OS-MPPT/os-mppt.github.io/index.md

# OS-MPPT: The OS-Some MPPT

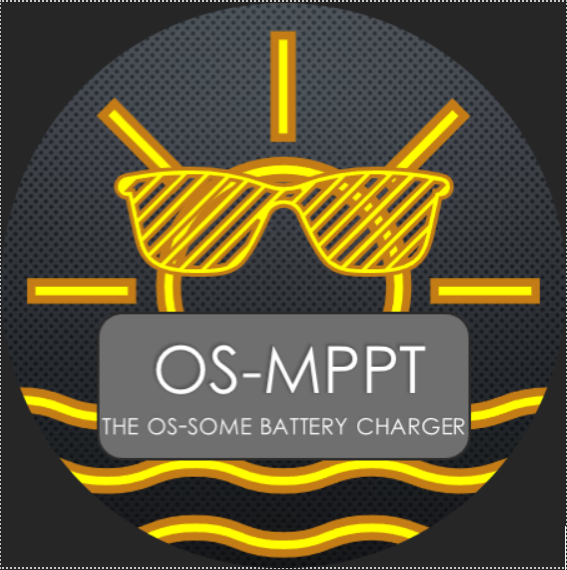
[picture p1: assets/SunnyOSMPPT.png]
Sunny


## OS? MPPT? What's that?
We are the OS-MPPT project! This is an Open-Source Maximum Power Point tracker project as researched and designed by our Senior Design team at K-State. 

## Okay, but what's an MPPT?
A Maximum Power Point Tracker uses readings coming off your solar panels and adjusts its power conversion step in order to maximize the power going to the attached load.

It sounds quite complicated, doesn't well? Well, that leads us right into...

## What's this project about?
We wanted to better understand MPPT operations and be able to then share that knowledge to other ambitious engineers, DIYers, and researchers alike. So, what'd we do? We assembled a senior design team in order to research, design, and construct a MPPT system, hopefully in a way that leaves lots of loose ends for future designers to iterate on. 

## Alrighty, where do I start?
We've set up a small network of information systems in order to manage and organize both our designs and technical notes. 

You can find both our digital and our electrical design files here:
[OS-MPPT Electrical Design](https://github.com/tjtiede/OSMPPT)

And last but certainly not least, you can find additional design and technical notes at this blog page!
