OS-MPPT/os-mppt.github.io/assets/os-mppt_MainBoard_Top.stl

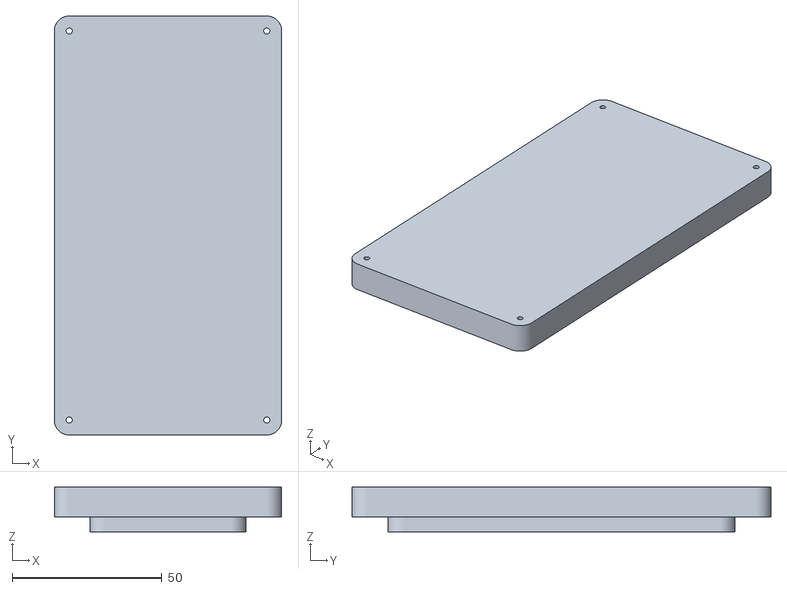
[picture p9: CAD file, 2026-05-04]
assets/os-mppt_MainBoard_Top.stl
76.0 x 140.0 x 15.0
