OS-MPPT/os-mppt.github.io/assets/os-mppt_MainBoard_Bottom.stl

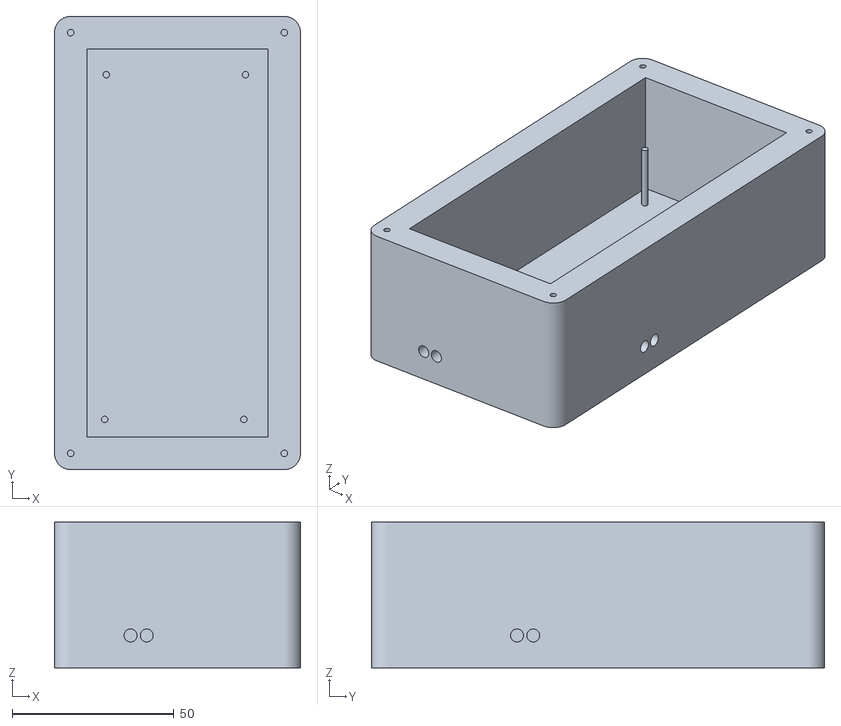
[picture p10: CAD file, 2026-05-04]
assets/os-mppt_MainBoard_Bottom.stl
76.0 x 140.0 x 45.0
