OS-MPPT/os-mppt.github.io/assets/os-mppt_ExternalSense_box.stl

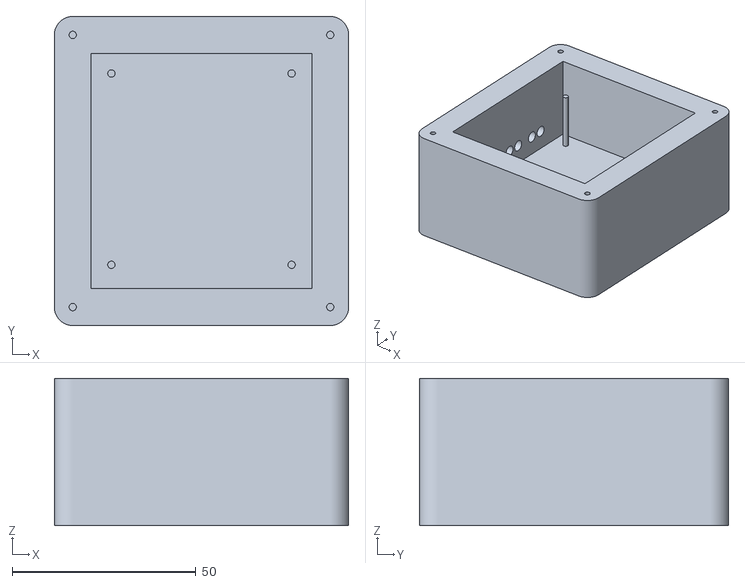
[picture p11: CAD file, 2026-05-04]
assets/os-mppt_ExternalSense_box.stl
80.0 x 84.0 x 40.0
