OS-MPPT/os-mppt.github.io/assets/os-mppt_ExternalSense_Top.stl

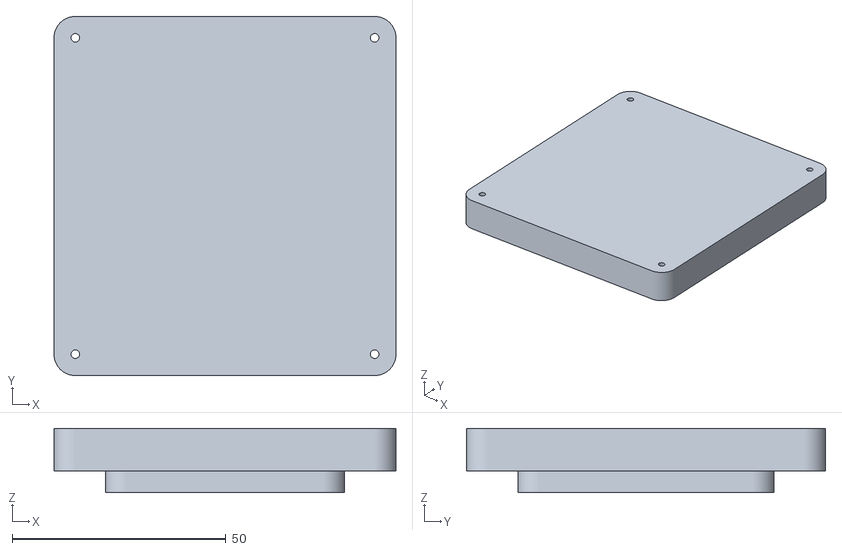
[picture p12: CAD file, 2026-05-04]
assets/os-mppt_ExternalSense_Top.stl
80.0 x 84.0 x 15.0
