OS-MPPT/os-mppt.github.io/(commit log)

2026-04-16 feat: updated first article, inserted missing git links, added site assets folder
2026-04-17 fix: rename assets, inserted images
